BIRDSOpenSource/BIRDS4-OBC/OBC BOM.xlsx

Sheet: B3_OBC20180205
Bill Of Materials January 16,2018 19:55:54 | Page1 | V0.16
Item | Quantity | Reference | Part
______________________________________________
1 | 1 | CN302 | 2row-50pin header R/A | 本多通信工業 | LPC-50M2LG | 2.00mmピッチ50pin | -25℃～85℃ | 偏差 | 1A
2 | 20 | C1,C2,C8,C10,C12,C13,C20 C21,C23,C29,C30,C33,C34, C40,C41,C62,C82,C83,C90, C91 | 10uF | 村田製作所 | GRM21BR71A106KE51L | 2012 | -55℃～125℃ | ±10% | 10V
3 | 15 | C3,C4,C5,C6,C14,C15,C16, C17,C25,C26,C27,C80,C84, C88,C92 | 22uF | 村田製作所 | GRM21BD71A226ME44L | 2012 | -55℃～125℃ | ±20% | 10V
4 | 37 | C7,C11,C18,C22,C32,C36, C37,C38,C43,C45,C46,C47, C48,C49,C50,C51,C52,C53, C54,C55,C59,C61,C63,C64, C65,C66,C67,C68,C69,C70, C71,C73,C74,C75,C76,C77, C78 | 0.1uF | KEMET | C0603C104J4RACTU | 1608 | -55℃～125℃ | ±5% | 16V
5 | 7 | C9,C19,C28,C35,C44,C85, C93 | 3300pF | Samsung | CL10B332KB8SFNC | 1608 | -55℃～125℃ | ±10% | 50V
6 | 2 | C24,C72 | 1uF | 村田製作所 | GRM188R71C105KA12J | 1608 | -55℃～125℃ | ±10% | 16V
7 | 1 | C31 | 10nF | 村田製作所 | GRM188R71C103KA01D | 1608 | -55℃～125℃ | ±10% | 16V
8 | 6 | C39,C42,C56,C57,C58,C60 | 12pF | 村田製作所 | GRM1882C1H120JA01D | 1608 | -55℃～85℃ | -5% | 50V
9 | 2 | C79,C87 | 33pF | KEMET | C0603C330K4RAC7867 | 1608 | -55℃～125℃ | ±10% | 16V
10 | 2 | C81,C89 | 560pF | 村田製作所 | GRM1882C1H560JZ01D | 1608 |  |  |  | メーカーサイトに品番なし
11 | 3 | C86,C94,C95 | 4.7uF | 村田製作所 | GRM188C71A475KE11D | 1608 | -55℃～125℃ | ±10% | 10V
12 | 1 | J1 | JUMPER | MAC8 | HWC-2P-G | 2mm SMT | －40～＋125℃ |  | 3A
13 | 3 | J2,J3,J4 | CONN SOCKET 3x2/SM | Samtec | CLM-103-02-F-D | 1mm ピッチ | -55℃ ～ 125℃
14 | 2 | L1,L2 | 1.5uH | Wurth Electronics | 74438357015 | 4.0x4.0 | -40℃～125℃ | ±20% | 6.2A(8.5A)
15 | 1 | L3 | 1uH | TDK | SPM5020T-1R0M | 5.6x5.3 | -40℃～125℃ | ±20% | 8.6A(9.6A Sat)
16 | 2 | L4,L5 | 4.7uH | Sumida | CDRH3D28NP-4R7NC | 3.80mm x 3.80mm | -40°C～125°C | ±20% | 3.4A
17 | 10 | Q1,Q3,Q5,Q7,Q8,Q10,Q11, Q13,Q14,Q16 | SSM6K411TU | TOSHIBA | SSM6K411TU | UF6 | -55℃～150℃
18 | 7 | Q2,Q4,Q6,Q9,Q12,Q15,Q17 | DTC144E | ON semiconductor | DTC144EET1G | SC-75 |  |  | hfe=80 min
19 | 4 | RN1,RN2,RN3,RN4 | 10Kx4 | Panasonic | EXB-28V103JX | 2010 | -55℃～125℃ | ±5% | 0.063W
20 | 3 | R1,R8,R15 | F0.025 | ROHM | UCR03EWPFSR024 | 1608 | -55℃～155℃ | ±1% | 0.25W | 24mΩ
21 | 4 | R2,R9,R102,R110 | F1M | KOA | RK73H1JTTD1004F | 1608 | -55℃～155℃ | ±1% | 0.1W
22 | 12 | R3,R10,R16,R27,R40,R48, R72,R85,R101,R108,R109, R115 | 10K | KOA | RK73B1JTTD103J | 1608 | -55℃～155℃ | ±5% | 0.1W
23 | 2 | R4,R11 | F180K | KOA | RK73H1JTTD1803F | 1608 | -55℃～155℃ | ±1% | 0.1W
24 | 5 | R5,R12,R18,R28,R42 | F0.025(2012) 1/4W | Panasonic | ERJ-6BWFR025V | 2012 | -55℃～155℃ | ±1% | 0.50W
25 | 5 | R6,R13,R20,R33,R43 | F100 | KOA | RK73H1JTTD1000F | 1608 | -55℃～155℃ | ±1% | 0.125W
26 | 8 | R7,R14,R23,R24,R35,R45, R46,R47 | F4.99K | Panasonic | ERA-3AEB4991V | 1608 | -55℃～155℃ | ±0.1%
27 | 1 | R17 | 0 | KOA | RK73Z1JTTD | 1608 | -55℃～155℃ | ±1%
28 | 1 | R19 | N.M(1608)
29 | 1 | R21 | F82.5K | KOA | RK73H1JTTD8252F | 1608 | -55℃～155℃ | ±1% | 0.1W | 代替可能 ERJ-3EKF8252V
30 | 21 | R22,R55,R56,R57,R59,R60, R61,R87,R88,R89,R90,R91, R92,R93,R94,R99,R106, R116,R117,R119,R120 | 100K | KOA | RK73B1JTTD104J | 1608 | -55℃～155℃ | ±5% | 0.1W
31 | 4 | R25,R26,R36,R39 | F0.033 | Panasonic | ERJ-3BWFR033V | 1608 | -55℃～155℃ | ±1% | 0.333W
32 | 32 | R29,R37,R58,R62,R63,R64, R65,R66,R67,R68,R69,R70, R71,R73,R74,R75,R76,R77, R78,R79,R80,R81,R82,R83, R84,R86,R95,R96,R97,R98, R118,R121 | 100 | KOA | RK73B1JTTD101J | 1608 | -55℃～155℃ | ±5% | 0.1W
33 | 12 | R30,R31,R32,R38,R41,R49, R50,R51,R52,R53,R54,R122 | 1K | KOA | RK73B1JTTD102J | 1608 | -55℃～155℃ | ±5% | 0.1W
34 | 2 | R34,R44 | F2.0K | KOA | RK73H1JTTD2001F | 1608 | -55℃～155℃ | ±1% | 0.1W
35
36 | 3 | R100,R107,R114 | F1.0 | Yageo | RC0603FR-071RL | 1608 | -55℃～155℃ | ±1% | 0.1W
37 | 2 | R103,R111 | 15K | KOA | RK73B1JTTD152J | 1608 | -55℃～155℃ | ±5% | 0.1W
38 | 2 | R104,R112 | F33.2K | Yageo | RC0603FR-0733K2L | 1608 | -55℃～155℃ | ±1% | 0.1W
39 | 2 | R105,R113 | F576K | Yageo | RC0603FR-07576KL | 1608 | -55℃～155℃ | ±1% | 0.1W
40 | 2 | U1,U4 | TPS63020-Q1 | Texas Instruments | TPS63020QDSJTQ1 | 14ピンVSON | -40～150℃
41 | 8 | U2,U5,U8,U10,U15,U37,U38, U40 | LTC4361-2 | LINEARTECHNOLOGY | LTC4361IDC-2#TRMPBF | 8ピンDFN | -40～85℃
42 | 5 | U3,U6,U9,U11,U17 | LT6106 | LINEARTECHNOLOGY | LT6106HS5#TRMPBF | 5ピンTSOT-23 | -40～125℃
43 | 1 | U7 | TPS61235RWLT | Texas Instruments | TPS61235PRWLT | 9ピンVQFN | -40～85℃
44 | 5 | U12,U20,U27,U28,U29 | SN74LVC2G34 | Texas Instruments | SN74LVC2G34DCKR | SC-70-6 | -40～125℃
45 | 1 | U13 | OV-7604-C7 | Micro Crystal | OV-7604-C7-STD-020 | SMD | -40～85℃ | RS compo
46 | 2 | U14,U26 | PIC16F1787 | MICROCHIP | PIC16F1787-E/MV | 40ピンUQFN | -40～125℃
47 | 1 | U16 | UMD5N | ROHM | UMD5NTR | UMT6 | -55～150℃
48 | 1 | U18 | STWD100 | ST Microelectronics | STWD100NYWY3F | SOT-23-53 | -40～125°C
49 | 3 | U19,U25,U31 | SN74CB3Q3305 | Texas Instruments | SN74CB3Q3305PWR | 8-TSSOP | -40～85℃
50 | 4 | U21,U22,U32,U34 | MT25QL01GBBB8ES | Micron | MT25QL01GBBB8ESF-0SIT | 16-SOIC | -40～85°C
51 | 1 | U23 | PIC18F67J94 | Micro Chip | PIC18F67J94-I/MR | 64-QFN（9x9) | -40～85℃
52 | 1 | U24 | SN74LVC1G125 | Texas Instruments | SN74LVC1G125DCKR | SC-70-5 | -40～125℃
53 | 1 | U30 | ADM3202 | Analog Devices | ADM3202ARUZ-REEL | 16-TSSOP | -40～85℃
54 | 2 | U33,U35 | SN74CB3Q3257 | Texas Instruments | SN74CB3Q3257DBQR | 16-SSOP | -40～85℃
55 | 2 | U36,U39 | LTC3530 | LINEARTECHNOLOGY | LTC3530EDD#PBF | 10-DFN（3x3） | -40～85℃
56 | 3 | X1,X2,X3 | 8MHz | AVX Corp/Kyocera Corp | CX5032GA08000H0PST02 | 2ピンSMD（5032） | -40～125℃ | 在庫なしの為変更(Cl=12pF)

Sheet: 変更履歴
変更履歴
番号 | 日付 | 対象 | 内容 | 変更理由 | 変更者
0 | 2018-01-18 |  | 初版発行(rev0.15) |  | 吉田
0.16 | 2018-01-24 | J2,J3,J4 | CLMシリーズコネクタに変更 | 顧客要望により | 吉田
 |  | その他R複数 | R追加、定数変更 | 空き端子処理、漏れにより | 吉田
0.161 | 2018-02-05 | U30 | ADM3202ARNZ-REEL→ADM3202ARUZ-REEL | 小型部品へ変更 | 吉田
 |  | L4,L5 | RLF7030T-4R7M3R4→CDRH3D28NP-4R7NC | 小型部品へ変更 | 吉田
 |  | R1,R8,R15 | →UCR03EWPFSR024 | 前機種で誤記部品 | 吉田
