BIRDSOpenSource/BIRDS4-OBC/BIRDS3-4 OBC Schematic.pdf

D | D

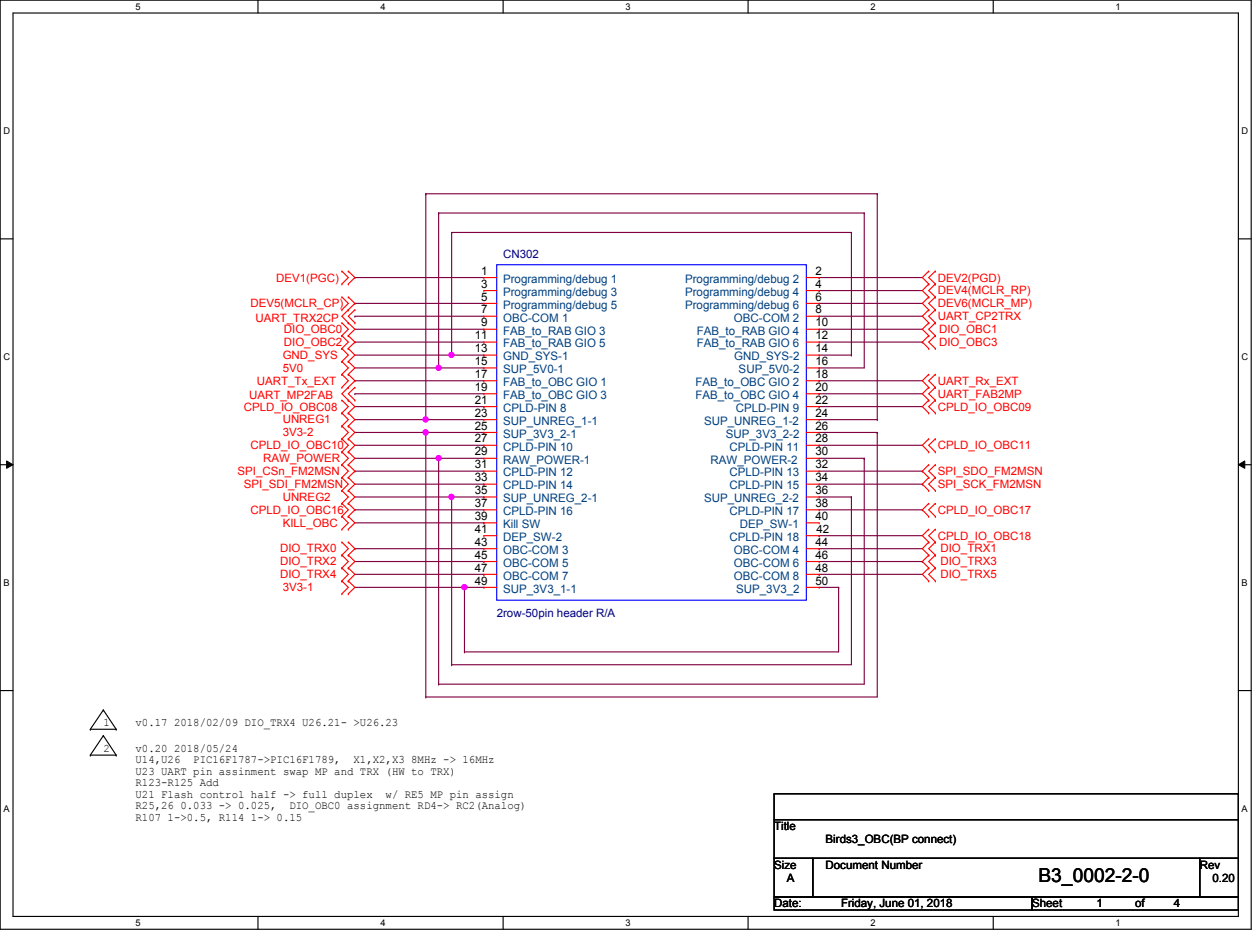
[picture p1: page 1]
1 v0.17 2018/02/09 DIO_TRX4 U26.21- >U26.23; DEV2(PGD) DEV4(MCLR_RP) DEV6(MCLR_MP); DEV1(PGC); DEV5(MCLR_CP); GND_SYS; UART_Tx_EXT; UART_Rx_EXT; UART_FAB2MP; CPLD_IO_OBC08; CPLD_IO_OBC10; UNREG1; RAW_POWER SPI_CSn_FM2MSN; CPLD_IO_OBC16 KILL_OBC; SPI_SDI_FM2MSN; CPLD_IO_OBC18; SPI_SDO_FM2MSN; CPLD_IO_OBC09; CPLD_IO_OBC11; CPLD_IO_OBC17; SPI_SCK_FM2MSN; DIO_TRX0; DIO_TRX1; DIO_TRX2; DIO_TRX3; UART_MP2FAB; UNREG2; UART_TRX2CP; UART_CP2TRX; DIO_TRX4; DIO_TRX5; DIO_OBC0; DIO_OBC1; DIO_OBC2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

U14,U26 PIC16F1787->PIC16F1789, X1,X2,X3 8MHz -> 16MHz
U23 UART pin assinment swap MP and TRX (HW to TRX)
R123-R125 Add
U21 Flash control half -> full duplex w/ RE5 MP pin assign
R25,26 0.033 -> 0.025, DIO_OBC0 assignment RD4-> RC2(Analog)

## Buck Boost 3.3V 1.8 < VIN < 5.5V

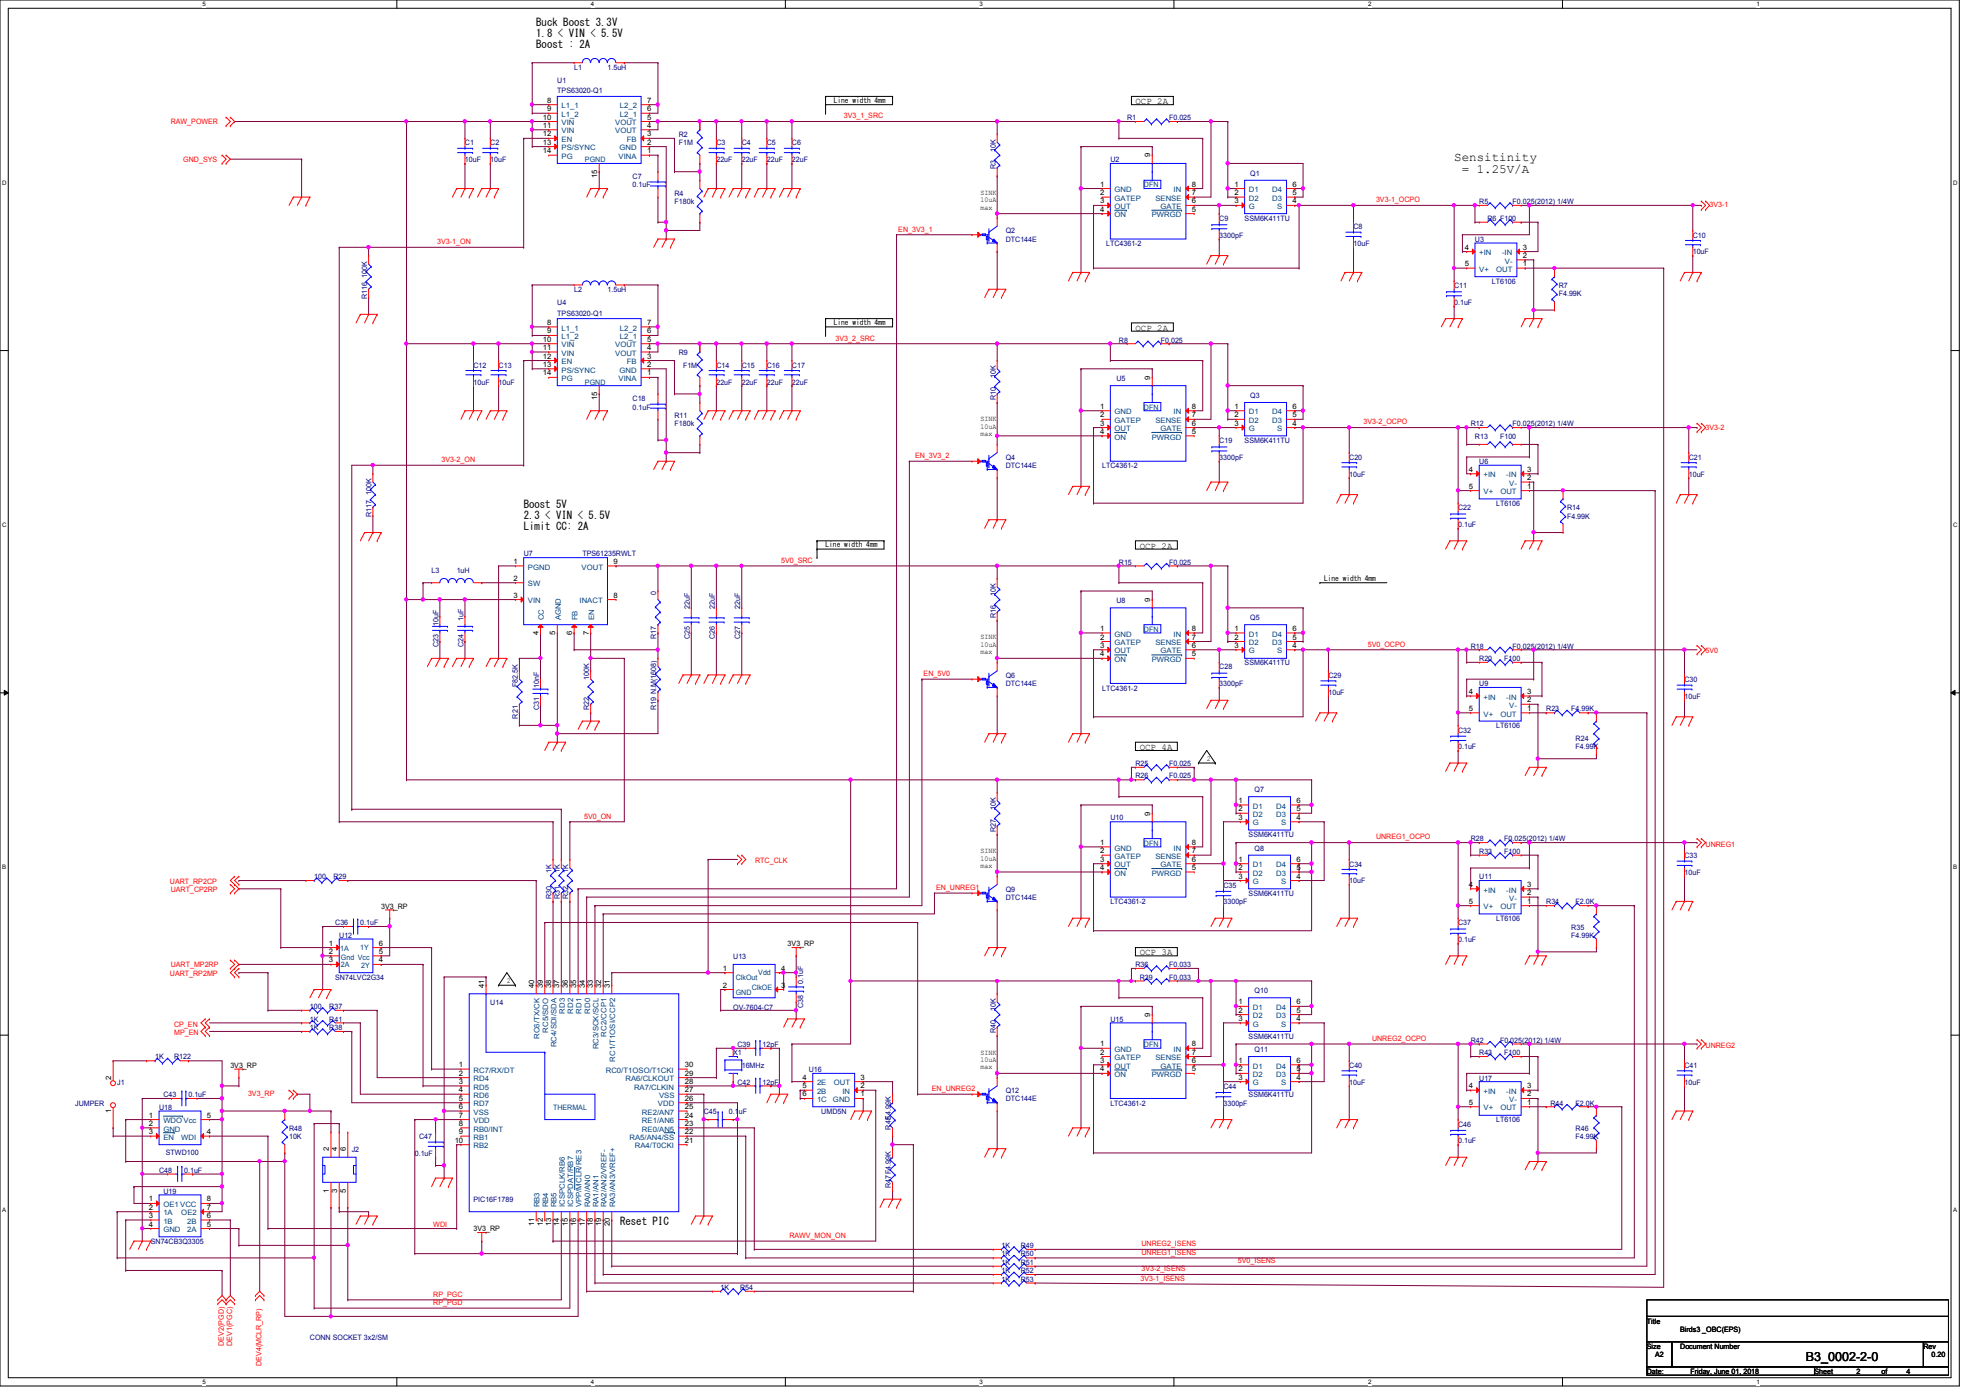
[picture p2: page 2]

## Flash Mem Dedicated for Main

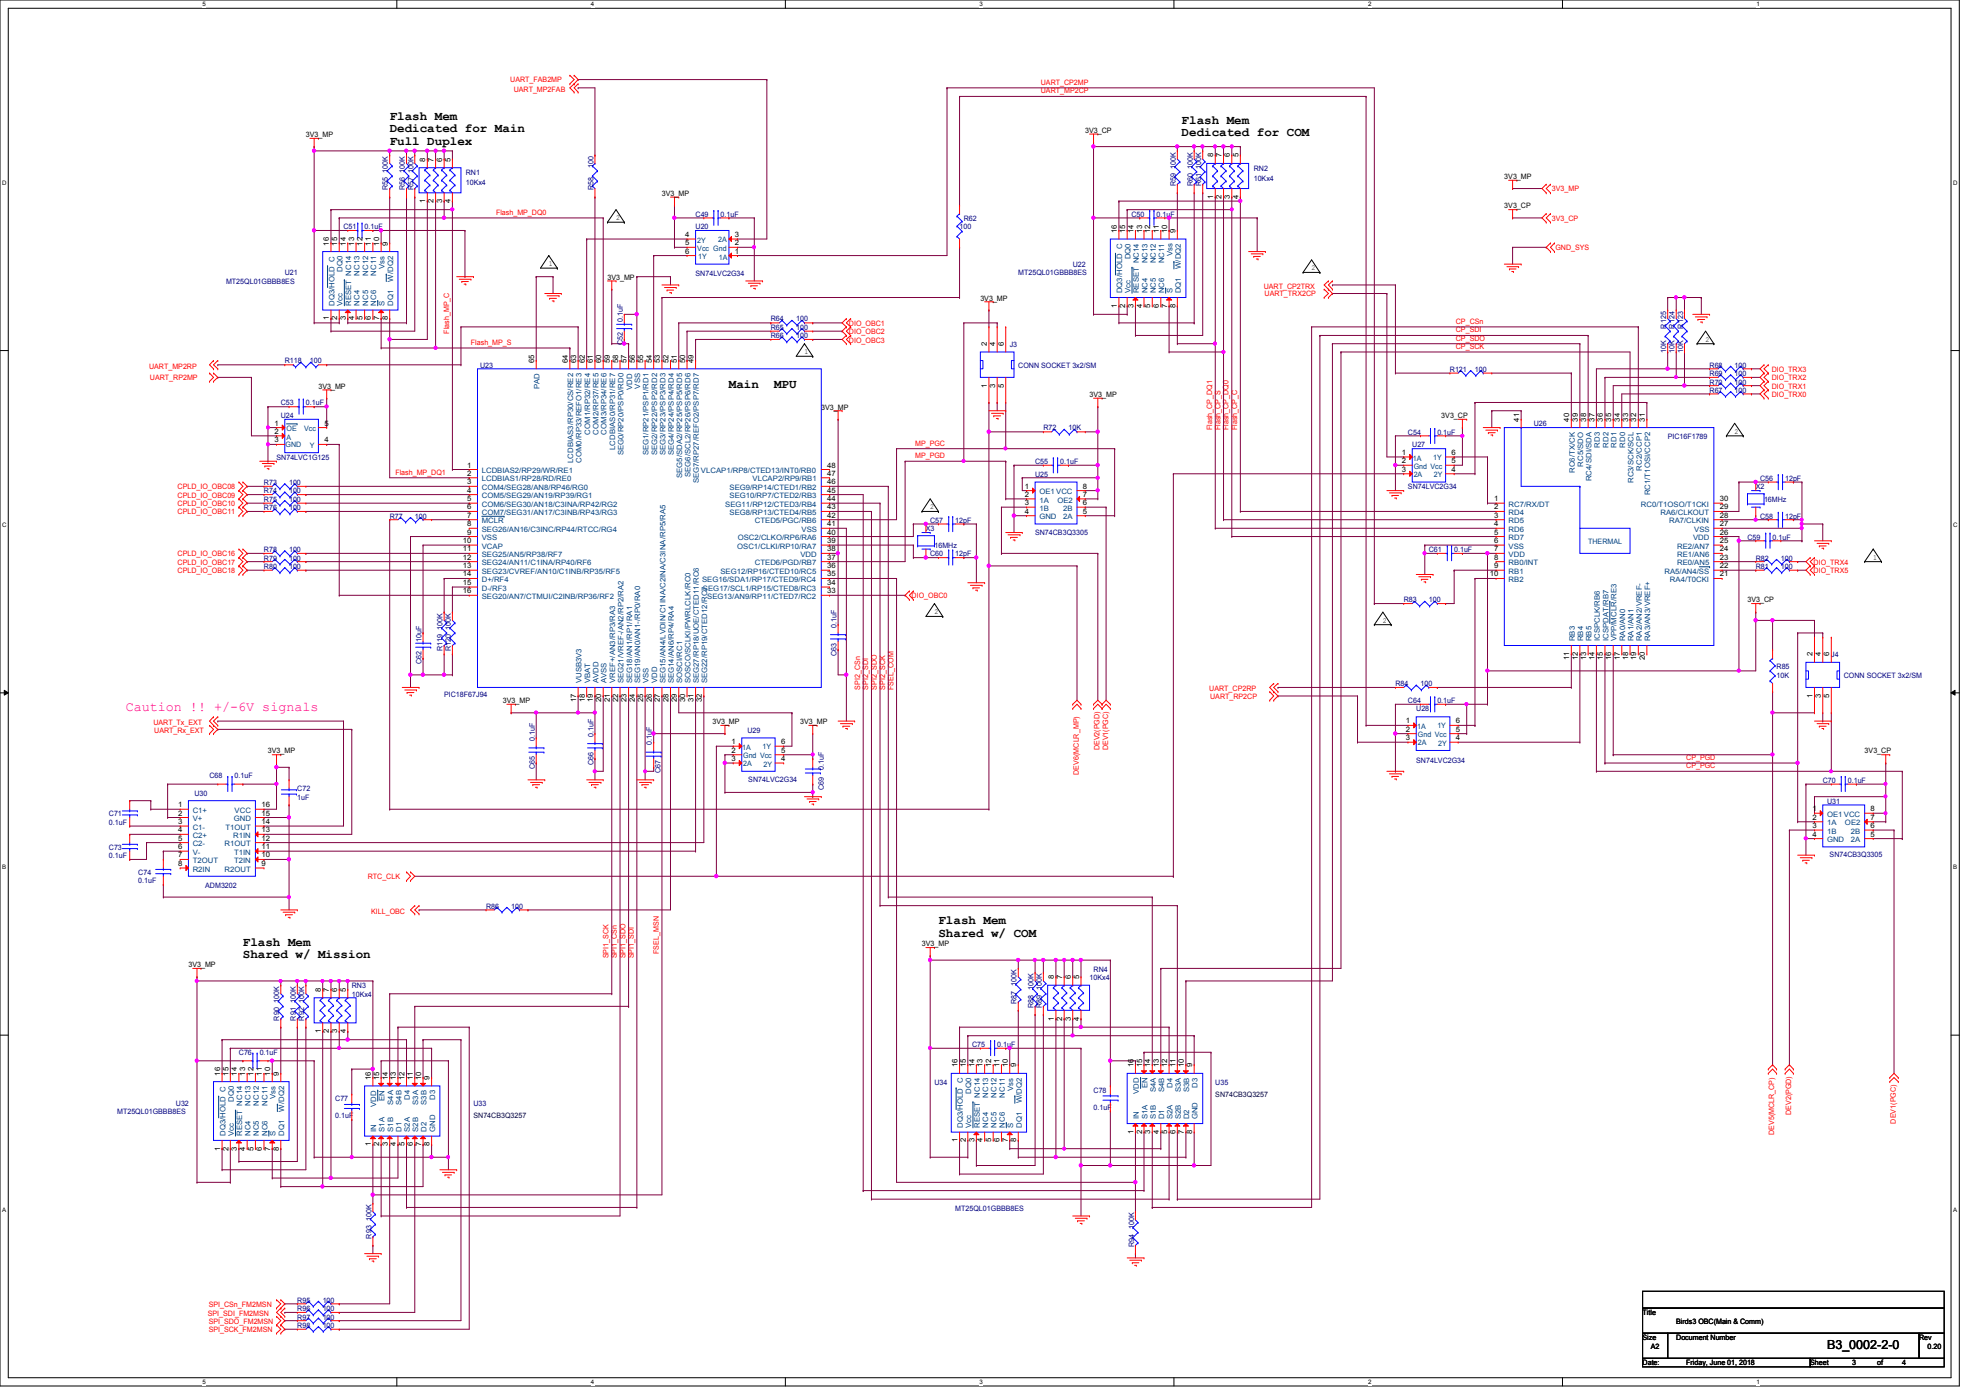
[picture p3: page 3]

CP_SDO
CP_SCK

12
13

# Limit 50mA

## RAW_POWER

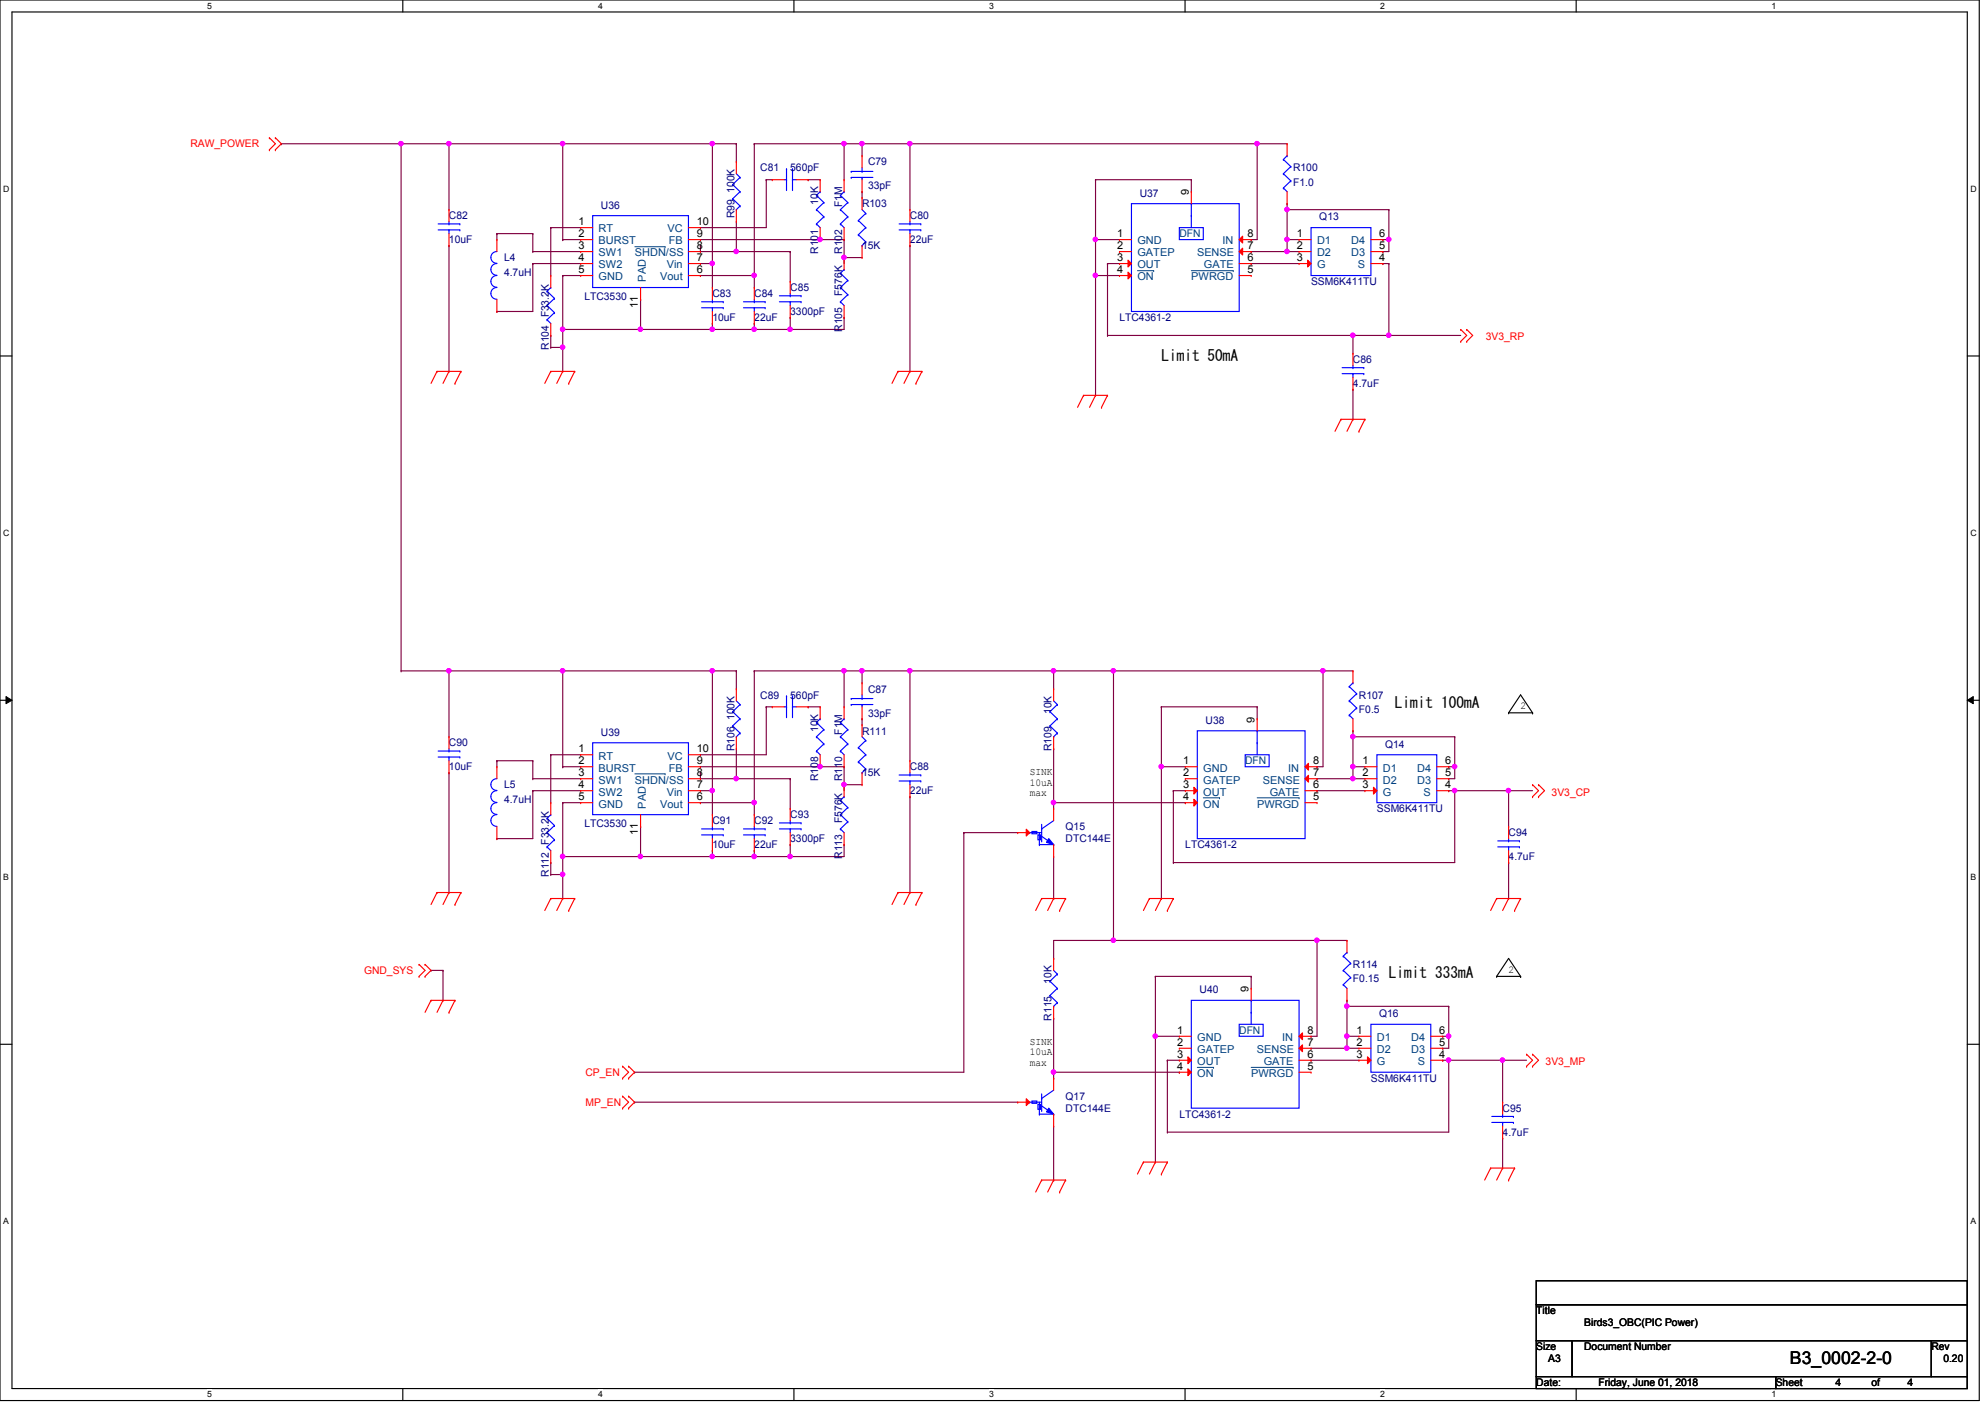
[picture p4: page 4]
