BIRDSOpenSource/BIRDS4-OBC/BIRDS4_COM_PIC_FM_FIRMWARE/COMPIC_CMMANDS.c

/*#define mision_data_down  (in_bffr[16]==0xAA) && (in_bffr[29]==0xEE) && (in_bffr[31]==0xCC)
#define take_photo        (in_bffr[16]==0xAA && in_bffr[29]==0xAA)
#define call_sign_check   (in_bffr[0]==0x62) && (in_bffr[1]==0x69) && (in_bffr[2]==0x72) && (in_bffr[3]==0x64) && (in_bffr[4]==0x73) //BIRDS
                                    
*/

                           
