BIRDSOpenSource/BIRDS4-OBC/BIRDS4_COM_PIC_FM_FIRMWARE/compicreg.h

#byte RCREG = 0x199
#byte PIR1 = 0x011
#bit  bit5 = PIR1.5


#byte PORTA = 0x00C
#bit    RA0 = PORTA.0
#bit    RA1 = PORTA.1
#bit    RA2 = PORTA.2
#bit    RA3 = PORTA.3
#bit    RA4 = PORTA.4
#bit    RA5 = PORTA.5
#bit    RA6 = PORTA.6
#bit    RA7 = PORTA.7

#byte PORTB = 0x00D
#bit    RB0 = PORTB.0
#bit    RB1 = PORTB.1
#bit    RB2 = PORTB.2
#bit    RB3 = PORTB.3
#bit    RB4 = PORTB.4
#bit    RB5 = PORTB.5
#bit    RB6 = PORTB.6
#bit    RB7 = PORTB.7

#byte PORTC = 0x00E
#bit    RC0 = PORTC.0
#bit    RC1 = PORTC.1
#bit    RC2 = PORTC.2
#bit    RC3 = PORTC.3
#bit    RC4 = PORTC.4
#bit    RC5 = PORTC.5
#bit    RC6 = PORTC.6
#bit    RC7 = PORTC.7

#byte PORTD = 0x00F
#bit    RD0 = PORTD.0
#bit    CW = PORTD.1
#bit    RD2 = PORTD.2
#bit    RD3 = PORTD.3
#bit    RD4 = PORTD.4
#bit    RD5 = PORTD.5
#bit    RD6 = PORTD.6
#bit    RD7 = PORTD.7

#byte PORTE = 0x010

#byte TRISA = 0x08C
#bit    TRISA0 = TRISA.0
#bit    TRISA1 = TRISA.1
#bit    TRISA2 = TRISA.2
#bit    TRISA3 = TRISA.3
#bit    TRISA4 = TRISA.4
#bit    TRISA5 = TRISA.5
#bit    TRISA6 = TRISA.6
#bit    TRISA7 = TRISA.7

#byte TRISB = 0x08D
#bit    TRISB0 = TRISB.0
#bit    TRISB1 = TRISB.1
#bit    TRISB2 = TRISB.2
#bit    TRISB3 = TRISB.3
#bit    TRISB4 = TRISB.4
#bit    TRISB5 = TRISB.5
#bit    TRISB6 = TRISB.6
#bit    TRISB7 = TRISB.7

#byte TRISC = 0x08E
#bit    TRISC0 = TRISC.0
#bit    TRISC1 = TRISC.1
#bit    TRISC2 = TRISC.2
#bit    TRISC3 = TRISC.3
#bit    TRISC4 = TRISC.4
#bit    TRISC5 = TRISC.5
#bit    TRISC6 = TRISC.6
#bit    TRISC7 = TRISC.7

#byte TRISD = 0x08F
#bit    TRISD0 = TRISD.0
#bit    TRISD1 = TRISD.1
#bit    TRISD2 = TRISD.2
#bit    TRISD3 = TRISD.3
#bit    TRISD4 = TRISD.4
#bit    TRISD5 = TRISD.5
#bit    TRISD6 = TRISD.6
#bit    TRISD7 = TRISD.7

#byte TRISE = 0x090

#byte LATA = 0x10C
#bit    LATA0 = LATA.0
#bit    LATA1 = LATA.1
#bit    LATA2 = LATA.2
#bit    LATA3 = LATA.3
#bit    LATA4 = LATA.4
#bit    LATA5 = LATA.5
#bit    LATA6 = LATA.6
#bit    LATA7 = LATA.7

#byte LATB = 0x10D
#bit    LATB0 = LATB.0
#bit    LATB1 = LATB.1
#bit    LATB2 = LATB.2
#bit    LATB3 = LATB.3
#bit    LATB4 = LATB.4
#bit    LATB5 = LATB.5
#bit    LATB6 = LATB.6
#bit    LATB7 = LATB.7

#byte LATC = 0x10E
#bit    LATC0 = LATC.0
#bit    LATC1 = LATC.1
#bit    LATC2 = LATC.2
#bit    LATC3 = LATC.3
#bit    LATC4 = LATC.4
#bit    LATC5 = LATC.5
#bit    LATC6 = LATC.6
#bit    LATC7 = LATC.7

#byte LATD = 0x10F
#bit    LATD0 = LATD.0
#bit    LATD1 = LATD.1
#bit    LATD2 = LATD.2
#bit    LATD3 = LATD.3
#bit    LATD4 = LATD.4
#bit    LATD5 = LATD.5
#bit    LATD6 = LATD.6
#bit    LATD7 = LATD.7

#byte T1CON = 0x018
#bit    TMR1ON = T1CON.0
#bit    T1SYNC = T1CON.2
#bit    T1OSCEN = T1CON.3
#bit    T1CKPS0 = T1CON.4
#bit    T1CKPS1 = T1CON.5
#bit    TMR1CS0 = T1CON.6
#bit    TMR1CS1 = T1CON.7
